markfickett/spinner/(commit log)

2017-02-19 Sense position and run magnet.
2017-03-08 Add circuit diagram image.
2017-05-25 Update README with spinner link and circuit followup.
